GrosGuillaume/Catapulte/Rapports seances/readme.md

Dans ce dossier il y aura les rapports des séances.
