GrosGuillaume/Catapulte/Informatique/README

Ici se trouve les algorithmes et programmes du projet
