GrosGuillaume/Catapulte/Informatique/algorithme.pdf

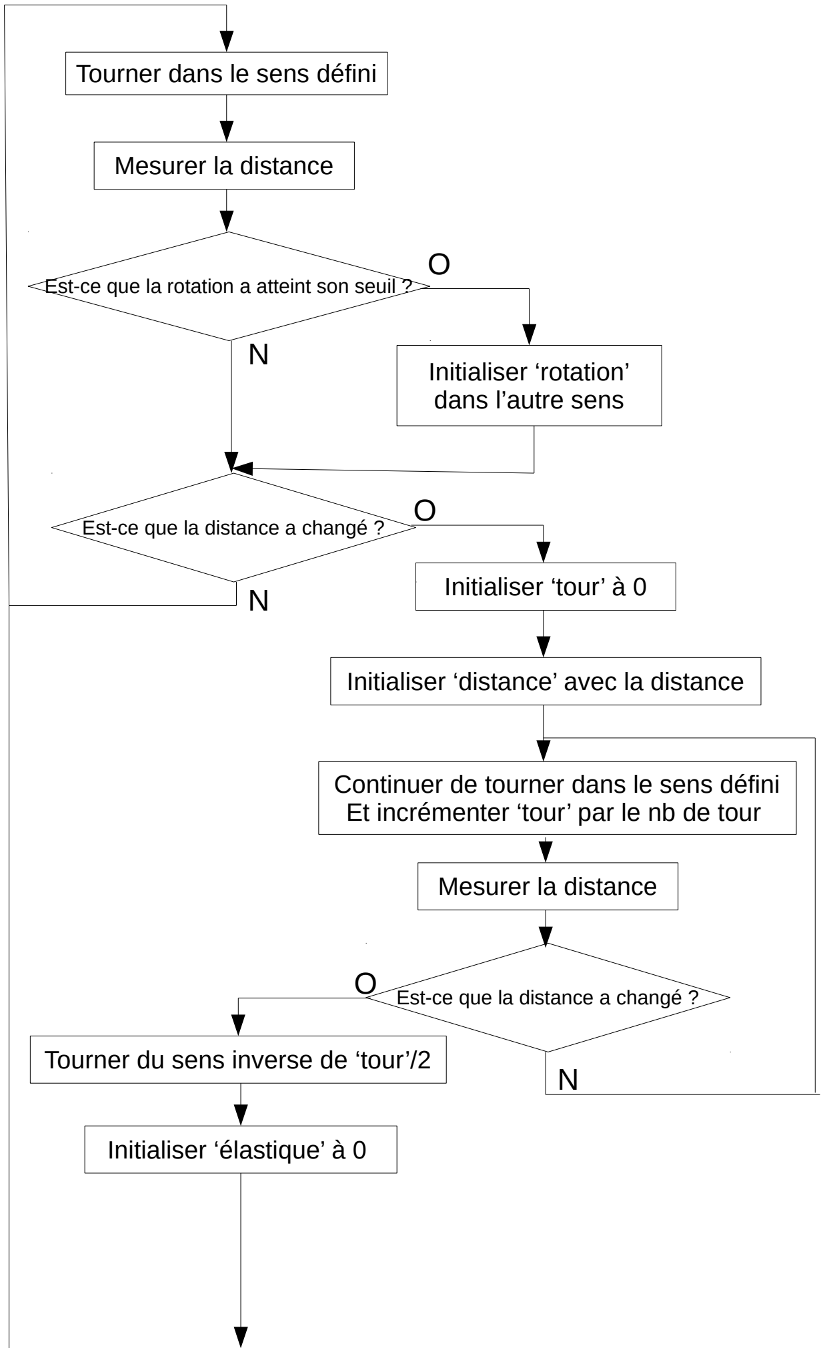
[picture p18: figure]
Tourner dans le sens défini; Mesurer la distance; Est-ce que la distance a changé ?; Initialiser ‘rotation’ dans l’autre sens; Et incrémenter ‘tour’ par le nb de tour; Initialiser ‘tour’ à 0; Tourner du sens inverse de ‘tour’/2; Initialiser ‘distance’ avec la distance; Initialiser ‘élastique’ à 0

Est-ce que la rotation a atteint son seuil ?

Continuer de tourner dans le sens défini

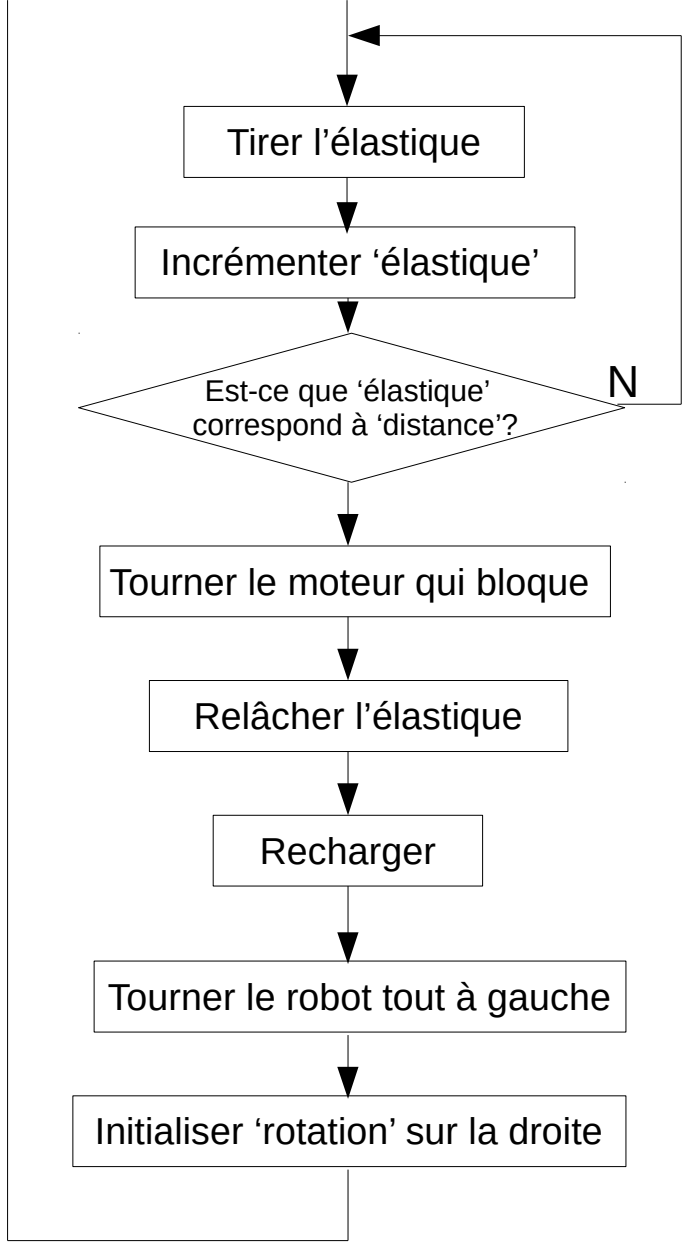
[picture p19: figure]
Est-ce que ‘élastique’ correspond à ‘distance’?; Incrémenter ‘élastique’; Tirer l’élastique; Tourner le moteur qui bloque; Tourner le robot tout à gauche; Initialiser ‘rotation’ sur la droite; Relâcher l’élastique; Recharger
