GrosGuillaume/Catapulte/Informatique/algorithme final.pdf

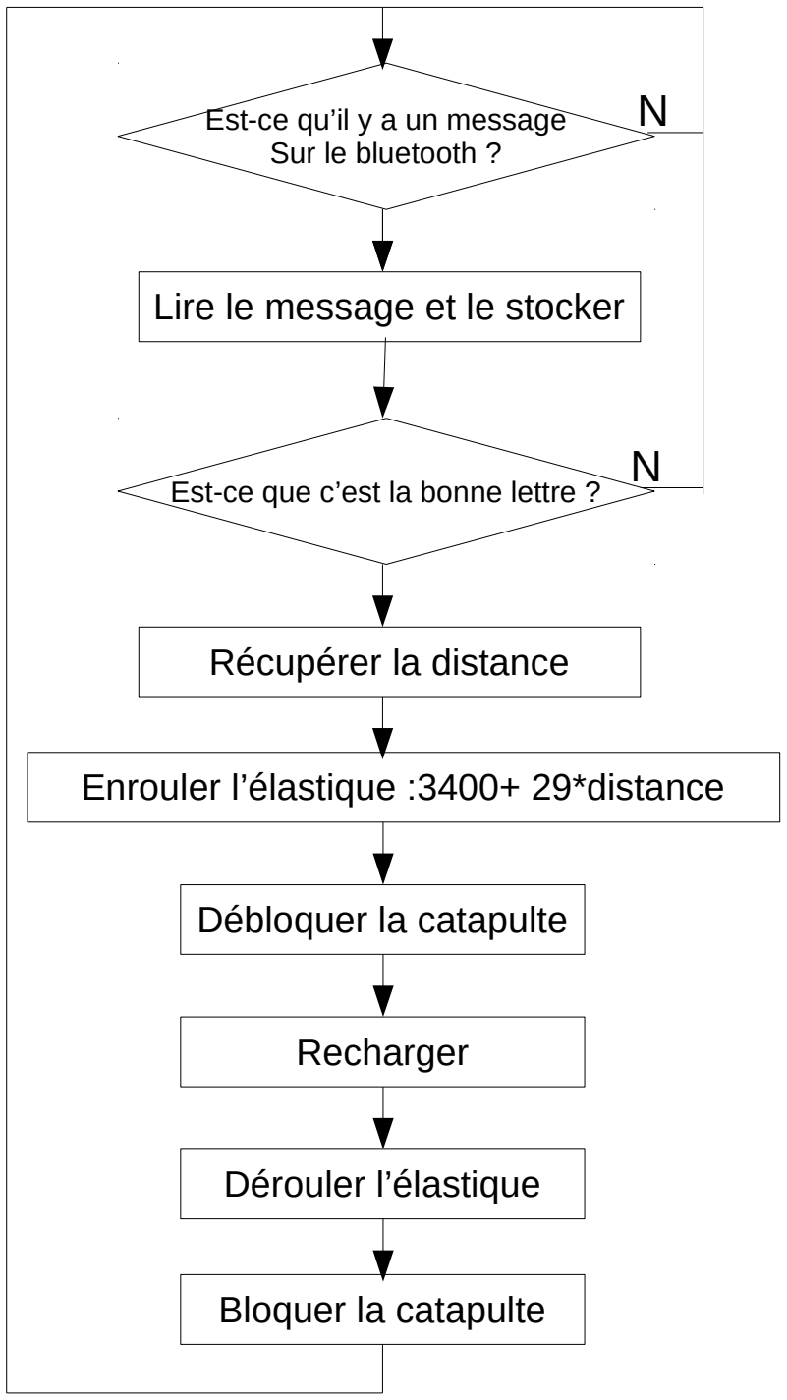
[picture p20: figure]
Est-ce qu’il y a un message Sur le bluetooth ?; Lire le message et le stocker; Est-ce que c’est la bonne lettre ?; Récupérer la distance; Enrouler l’élastique :3400+ 29*distance; Débloquer la catapulte; Recharger; Dérouler l’élastique; Bloquer la catapulte
